danieldeesousa/FYDP/Hardware/FindMe_Hub/Hub_Schematic.pdf

# VBATTRED BLUE

A

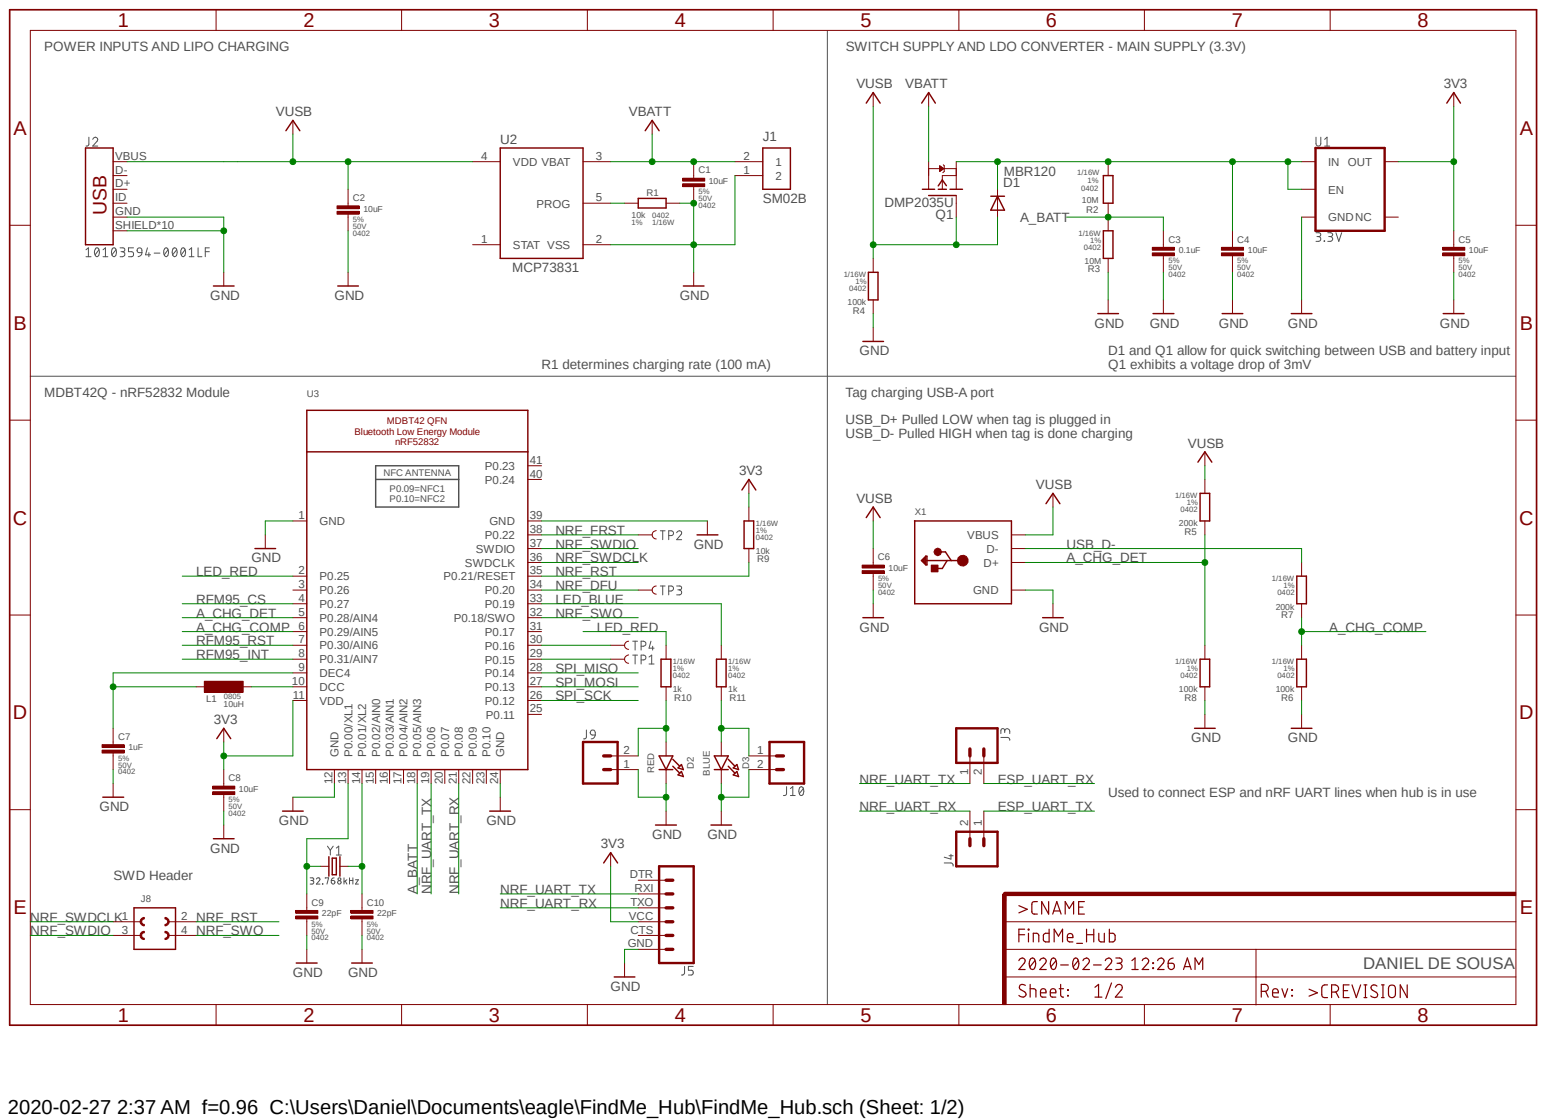
[picture p1: page 1]

POWER INPUTS AND LIPO CHARGING VUSB | SWITCH SUPPLY AND LDO CONVERTER - MAIN SUPPLY (3.3V) VUSB VBATT | 3V3

GND
D1 and Q1 allow for quick switching between USB and battery input

R1 determines charging rate (100 mA)

Q1 exhibits a voltage drop of 3mV

MDBT42Q - nRF52832 Module | | Tag charging USB-A port USB_D+ Pulled LOW when tag is plugged in USB_D- Pulled HIGH when tag is done charging VUSB

Bluetooth Low Energy Module

Used to connect ESP and nRF UART lines when hub is in use

2020-02-27 2:37 AM f=0.96 C:\Users\Daniel\Documents\eagle\FindMe_Hub\FindMe_Hub.sch (Sheet: 1/2)

# 3V3_ESP GND

A

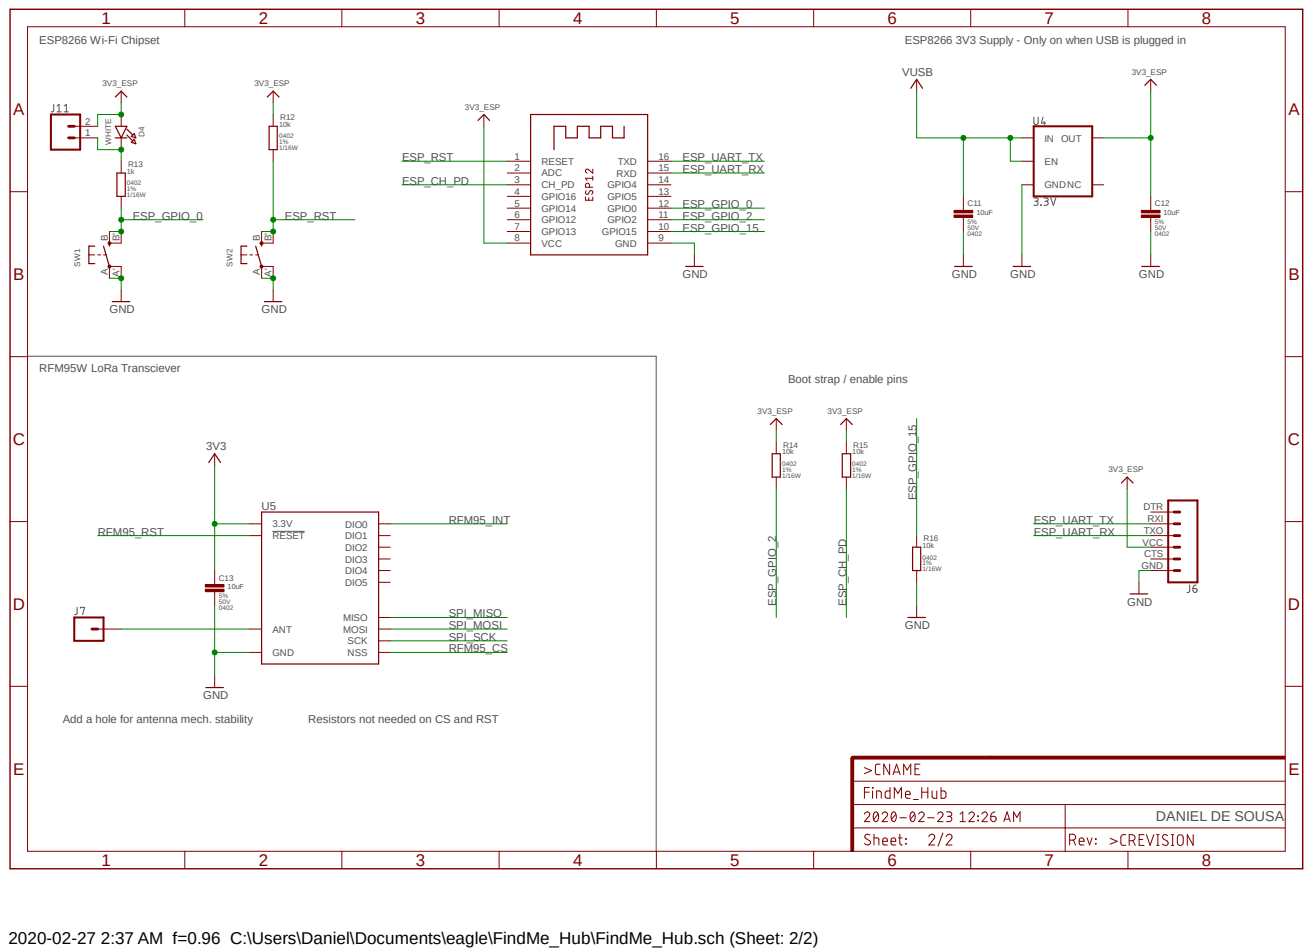
[picture p2: page 2]

ESP8266 3V3 Supply - Only on when USB is plugged in WHITE

Boot strap / enable pins

2020-02-27 2:37 AM f=0.96 C:\Users\Daniel\Documents\eagle\FindMe_Hub\FindMe_Hub.sch (Sheet: 2/2)
