danieldeesousa/FYDP/Hardware/FindMe_Tag/Tag_Schematic.pdf

A

A

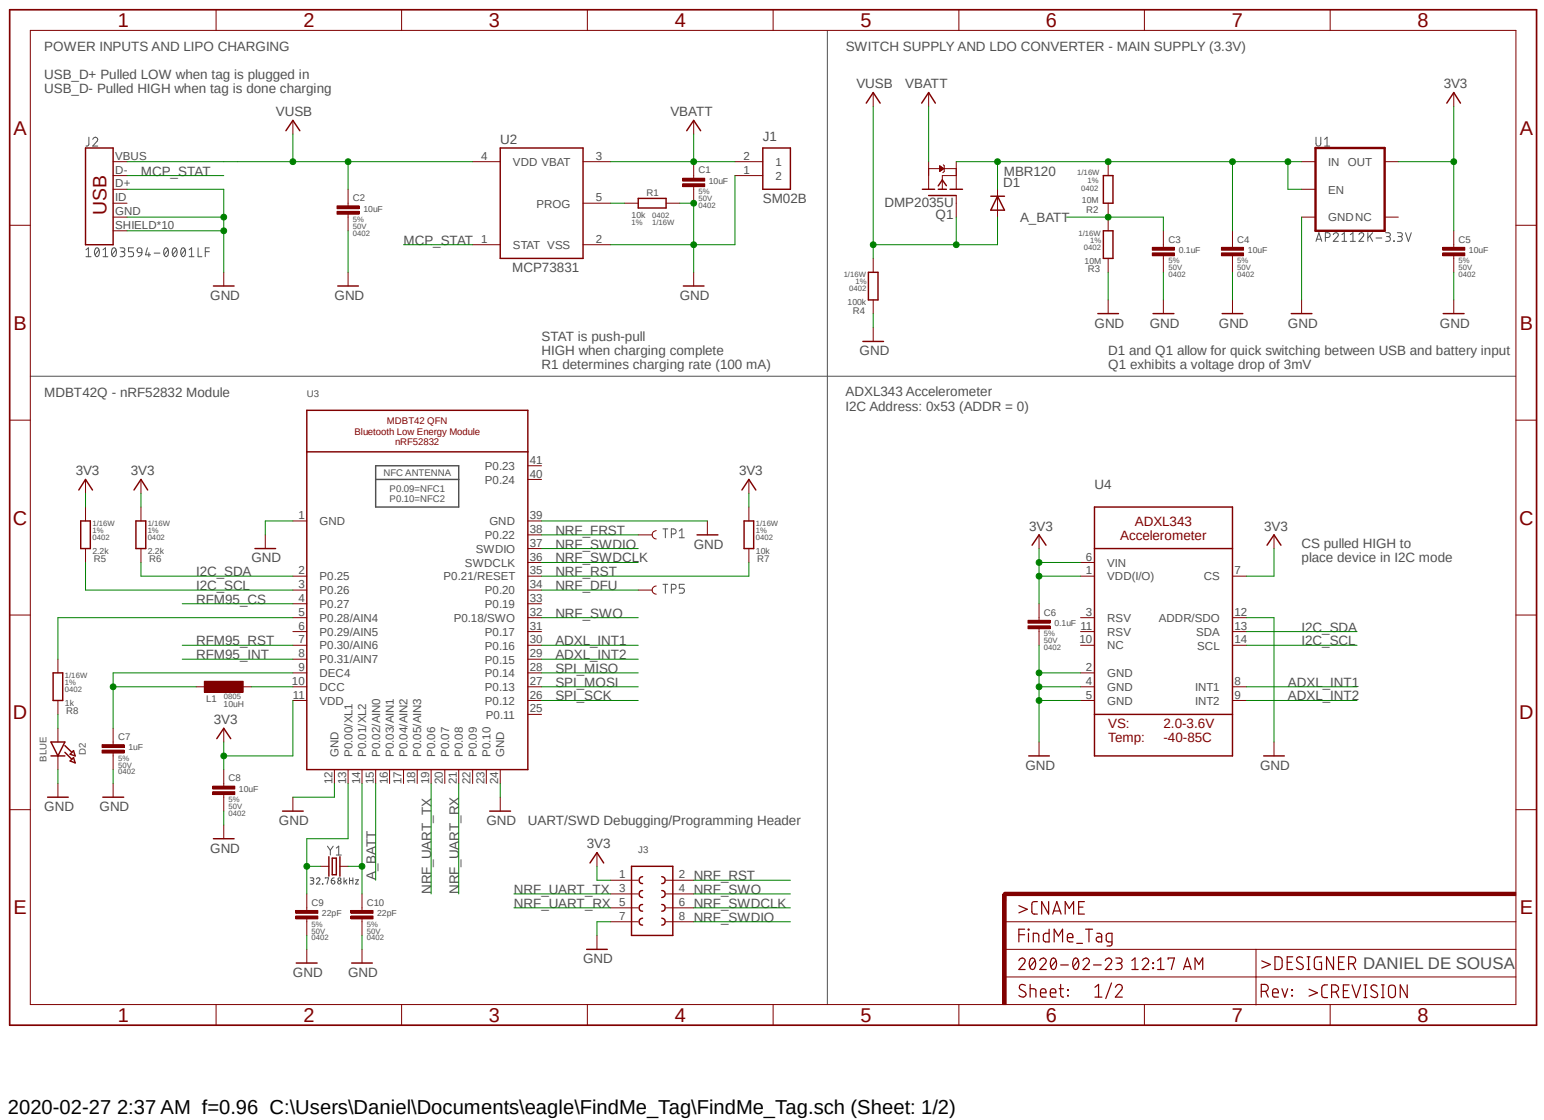
[picture p3: page 1]

USB_D+ Pulled LOW when tag is plugged in
USB_D- Pulled HIGH when tag is done charging

GND
D1 and Q1 allow for quick switching between USB and battery input
Q1 exhibits a voltage drop of 3mV

STAT is push-pull
HIGH when charging complete
R1 determines charging rate (100 mA)

MDBT42 QFN
Bluetooth Low Energy Module

CS pulled HIGH to
place device in I2C mode

UART/SWD Debugging/Programming Header

2020-02-27 2:37 AM f=0.96 C:\Users\Daniel\Documents\eagle\FindMe_Tag\FindMe_Tag.sch (Sheet: 1/2)

A

A

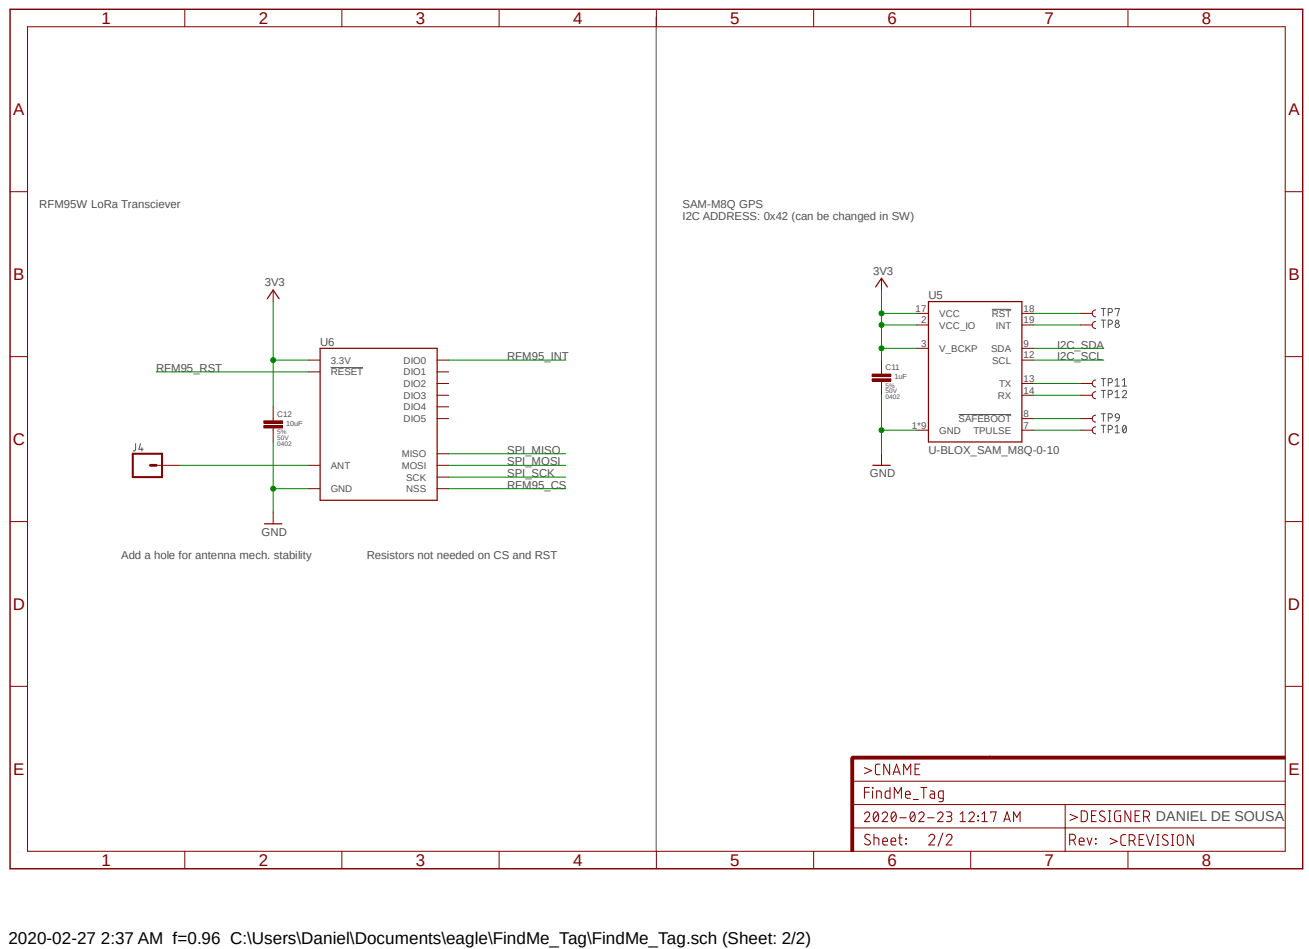
[picture p4: page 2]
RFM95W LoRa Transciever; Add a hole for antenna mech. stability; Resistors not needed on CS and RST; GND; U-BLOX_SAM_M8Q-0-10; 3V3 RESET; ANT; DIO0 DIO1 DIO2 DIO3 DIO4 DIO5 GND; MISO MOSI NSS; SCK U6; GND 1*9; VCC 17; RST; INT; 19 SDA; 9 SCL; 14 SAFEBOOT; 8 TPULSE; 7 V_BCKP 3; VCC_IO 2 U5 C12; C11 SPI_SCK; SPI_MOSI; SPI_MISO; RFM95_CS; RFM95_RST; RFM95_INT; I2C_SDA I2C_SCL

SAM-M8Q GPS
I2C ADDRESS: 0x42 (can be changed in SW)

DANIEL DE SOUSA

2020-02-27 2:37 AM f=0.96 C:\Users\Daniel\Documents\eagle\FindMe_Tag\FindMe_Tag.sch (Sheet: 2/2)
