danieldeesousa/FYDP/Hardware/FindMe_Tag/FindMe_Tag.brd

## EAGLE design Hardware/FindMe_Tag/FindMe_Tag.brd (2020-02-28)

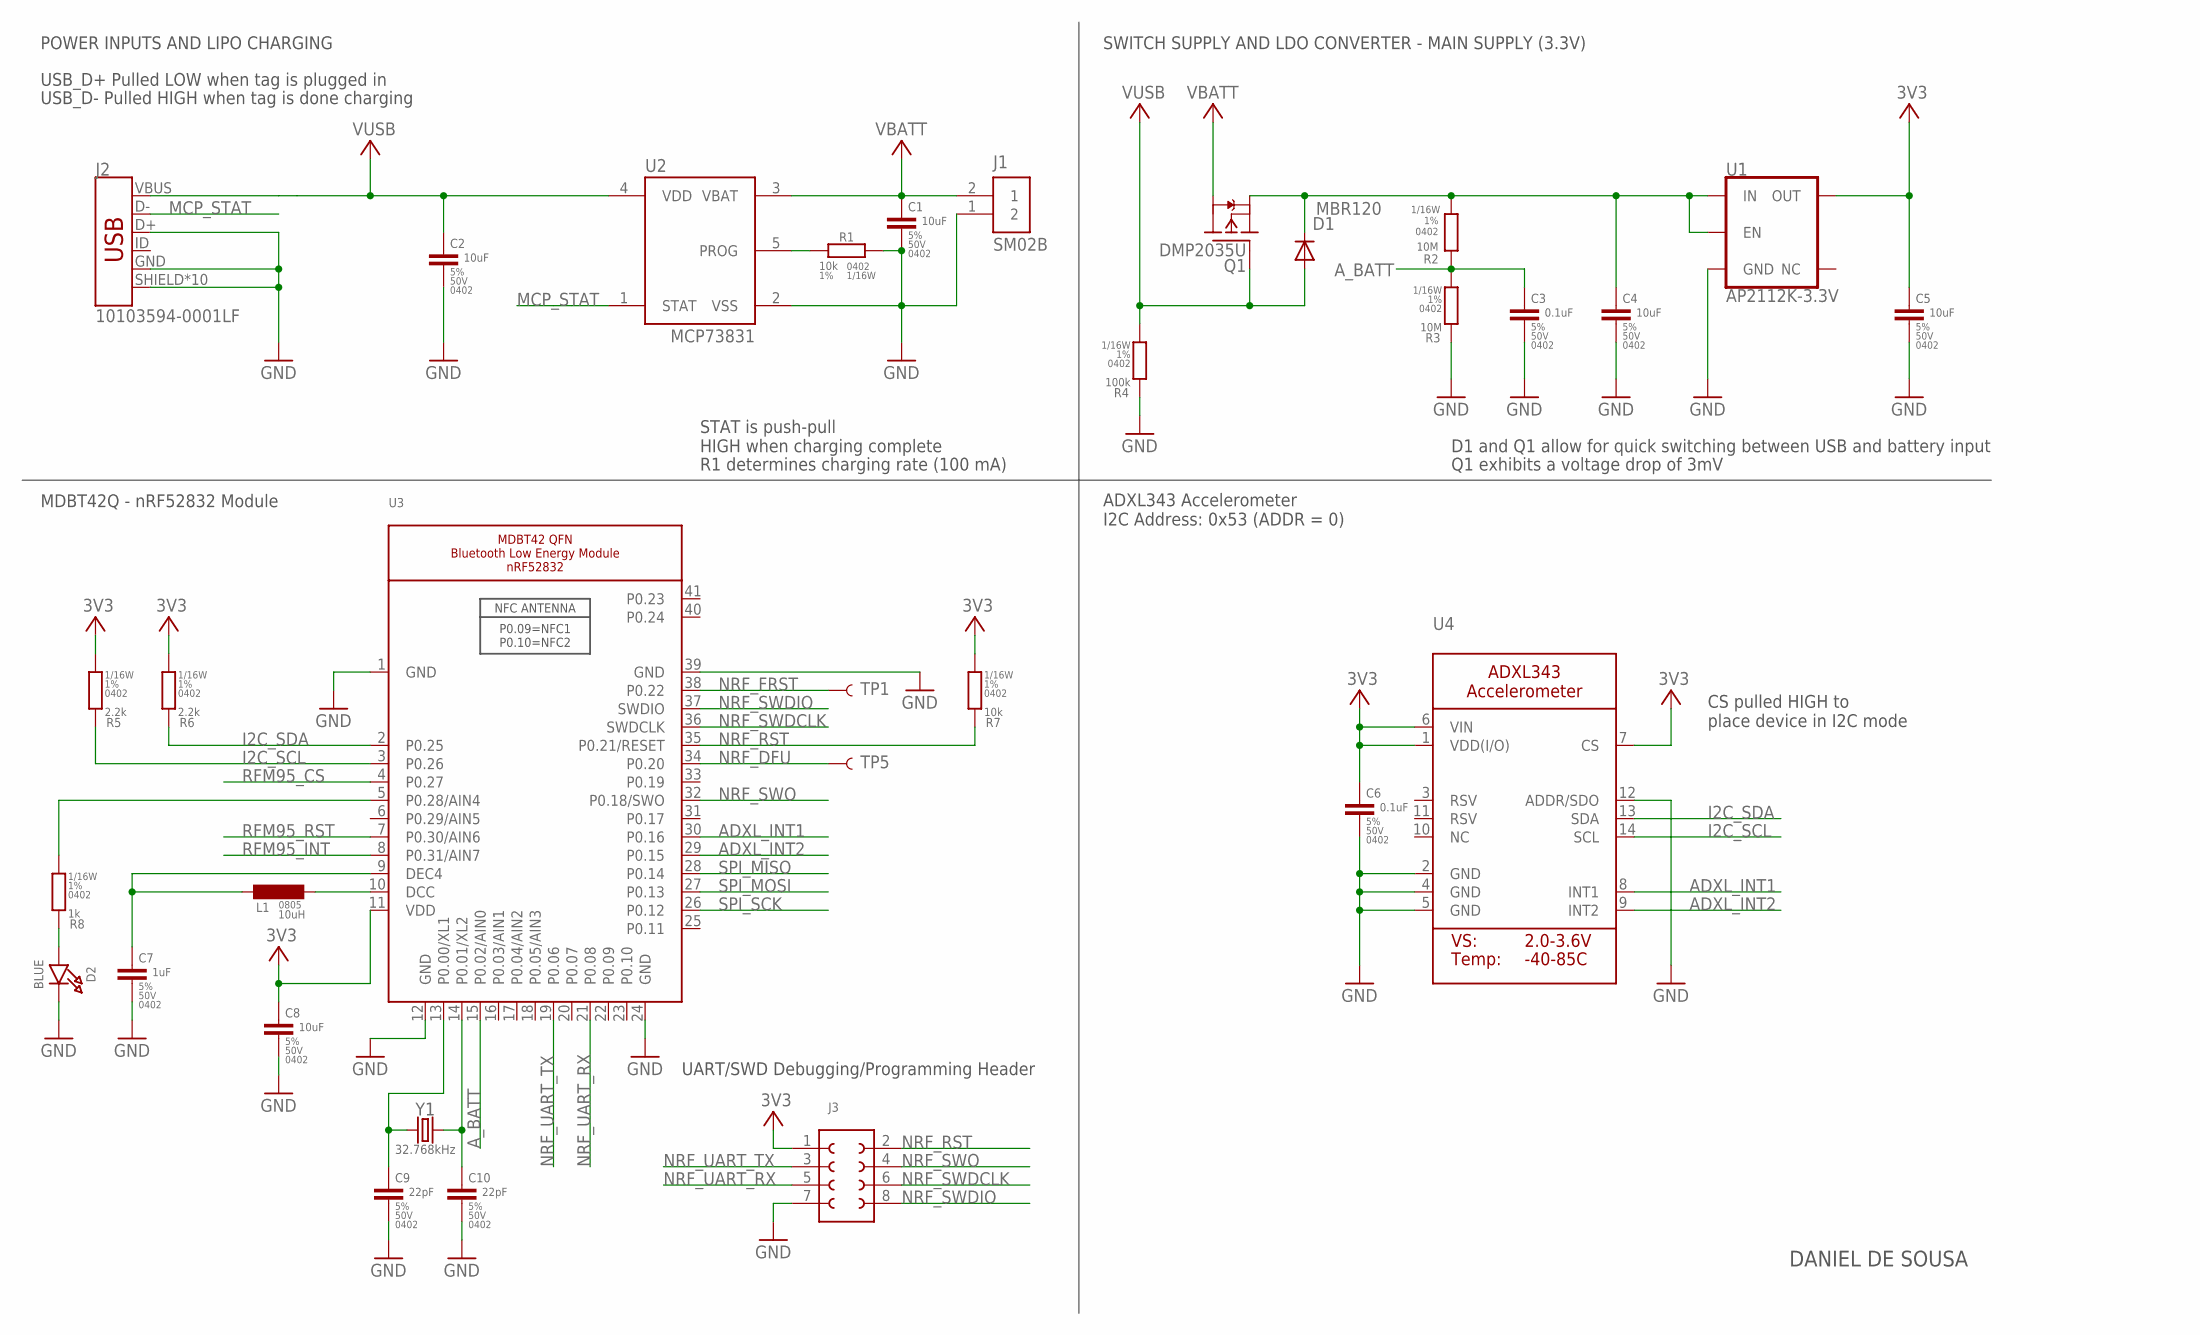
[picture p5: schematic FindMe_Tag.sch, sheet 1]

Parts:
C1, C2, C4, C5, C8: 10uF; C0402_MURATA_GRM15-GJM15
C3, C6: 0.1uF; C0402_MURATA_GRM15-GJM15
C7: 1uF; C0402_MURATA_GRM15-GJM15
C9, C10: 22pF; C0402_MURATA_GRM15-GJM15
D1: MBR120; SOD-123FL
D2: BLUE; CHIPLED_0805_NOOUTLINE
J1: SM02B; JST_SH_2X1
J2: 10103594-0001LF; USB-MICROB-PTH-MILL
J3: 610X08243021
L1: 10uH; L0805_MURATA_LQM21
Q1: DMP2035U; SOT23
R1, R7: 10k; R0402_VISHAY_CRCW0402
R2, R3: 10M; R0402_VISHAY_CRCW0402
R4: 100k; R0402_VISHAY_CRCW0402
R5, R6: 2.2k; R0402_VISHAY_CRCW0402
R8: 1k; R0402_VISHAY_CRCW0402
TP1, TP5: TEST-POINT3; PAD.03X.03
U1: AP2112K-3.3V; SOT23-5
U2: MCP73831; SOT-23
U3: NRF52832_MODULE_MDBT42; BLE_MODULE_RAYTAC_MDBT42
U4: ACCEL_ADXL343; LGA14
Y1: 32.768kHz; CRYSTAL-SMD-3.2X1.5MM

Connections:
+3V3: C5.1, C6.1, C8.1, J3.1, R5.2, R6.2, R7.2, U1.5 (OUT), U3.11 (VDD), U4.1 (VDD(I/O)), U4.6 (VIN), U4.7 (CS); also elsewhere on the board
ADXL_INT1: U3.30 (P0.16), U4.8 (INT1)
ADXL_INT2: U3.29 (P0.15), U4.9 (INT2)
A_BATT: C3.1, R2.1, R3.2, U3.15 (P0.02/AIN0)
GND: C1.2, C2.2, C3.2, C4.2, C5.2, C6.2, C7.2, C8.2, C9.2, C10.2, D2.C, J1.1 (2), J2.D+, J2.GND, J2.SHIELD, J2.SHIELD2 (SHIELD), J2.SHIELD3 (SHIELD), J2.SHIELD4 (SHIELD), J2.SHIELD5 (SHIELD), J2.SHIELD6 (SHIELD), J2.SHIELD7 (SHIELD), J2.SHIELD8 (SHIELD), J2.SHIELD9 (SHIELD), J2.SHIELD10 (SHIELD), J3.7 (4), R1.1, R3.1, R4.1, U1.2 (GND), U2.2 (VSS), U3.1 (GND), U3.12 (GND), U3.24 (GND), U3.39 (GND), U4.2 (GND), U4.4 (GND), U4.5 (GND), U4.12 (ADDR/SDO); also elsewhere on the board
I2C_SCL: R5.1, U3.3 (P0.26), U4.14 (SCL); also elsewhere on the board
I2C_SDA: R6.1, U3.2 (P0.25), U4.13 (SDA); also elsewhere on the board
MCP_STAT: J2.D-, U2.1 (STAT)
unnamed: R1.2, U2.5 (PROG)
unnamed: C4.1, D1.C, Q1.E (S), R2.2, U1.1 (IN), U1.3 (EN)
unnamed: C9.1, U3.13 (P0.00/XL1), Y1.P$1 (1)
unnamed: C10.1, U3.14 (P0.01/XL2), Y1.P$2 (2)
unnamed: L1.P$2 (2), U3.10 (DCC)
unnamed: C7.1, L1.P$1 (1), U3.9 (DEC4)
unnamed: R8.2, U3.5 (P0.28/AIN4)
unnamed: D2.A, R8.1
NRF_DFU: TP5.P$1, U3.34 (P0.20)
NRF_FRST: TP1.P$1, U3.38 (P0.22)
NRF_RST: J3.2 (8), R7.1, U3.35 (P0.21/RESET)
NRF_SWDCLK: J3.6, U3.36 (SWDCLK)
NRF_SWDIO: J3.8 (5), U3.37 (SWDIO)
NRF_SWO: J3.4 (7), U3.32 (P0.18/SWO)
NRF_UART_RX: J3.5 (3), U3.21 (P0.08)
NRF_UART_TX: J3.3 (2), U3.19 (P0.06)
RFM95_CS: U3.4 (P0.27); also elsewhere on the board
RFM95_INT: U3.8 (P0.31/AIN7); also elsewhere on the board
RFM95_RST: U3.7 (P0.30/AIN6); also elsewhere on the board
SPI_MISO: U3.28 (P0.14); also elsewhere on the board
SPI_MOSI: U3.27 (P0.13); also elsewhere on the board
SPI_SCK: U3.26 (P0.12); also elsewhere on the board
VBATT: C1.1, J1.2 (1), Q1.C (D), U2.3 (VBAT)
VUSB: C2.1, D1.A, J2.VBUS, Q1.B (G), R4.2, U2.4 (VDD)

Notes on the sheet:
ADXL343 Accelerometer I2C Address: 0x53 (ADDR = 0)
POWER INPUTS AND LIPO CHARGING
SWITCH SUPPLY AND LDO CONVERTER - MAIN SUPPLY (3.3V)
STAT is push-pull HIGH when charging complete
R1 determines charging rate (100 mA)
D1 and Q1 allow for quick switching between USB and battery input
DANIEL DE SOUSA
Q1 exhibits a voltage drop of 3mV
MDBT42Q - nRF52832 Module
USB_D- Pulled HIGH when tag is done charging
USB_D+ Pulled LOW when tag is plugged in
CS pulled HIGH to place device in I2C mode
UART/SWD Debugging/Programming Header

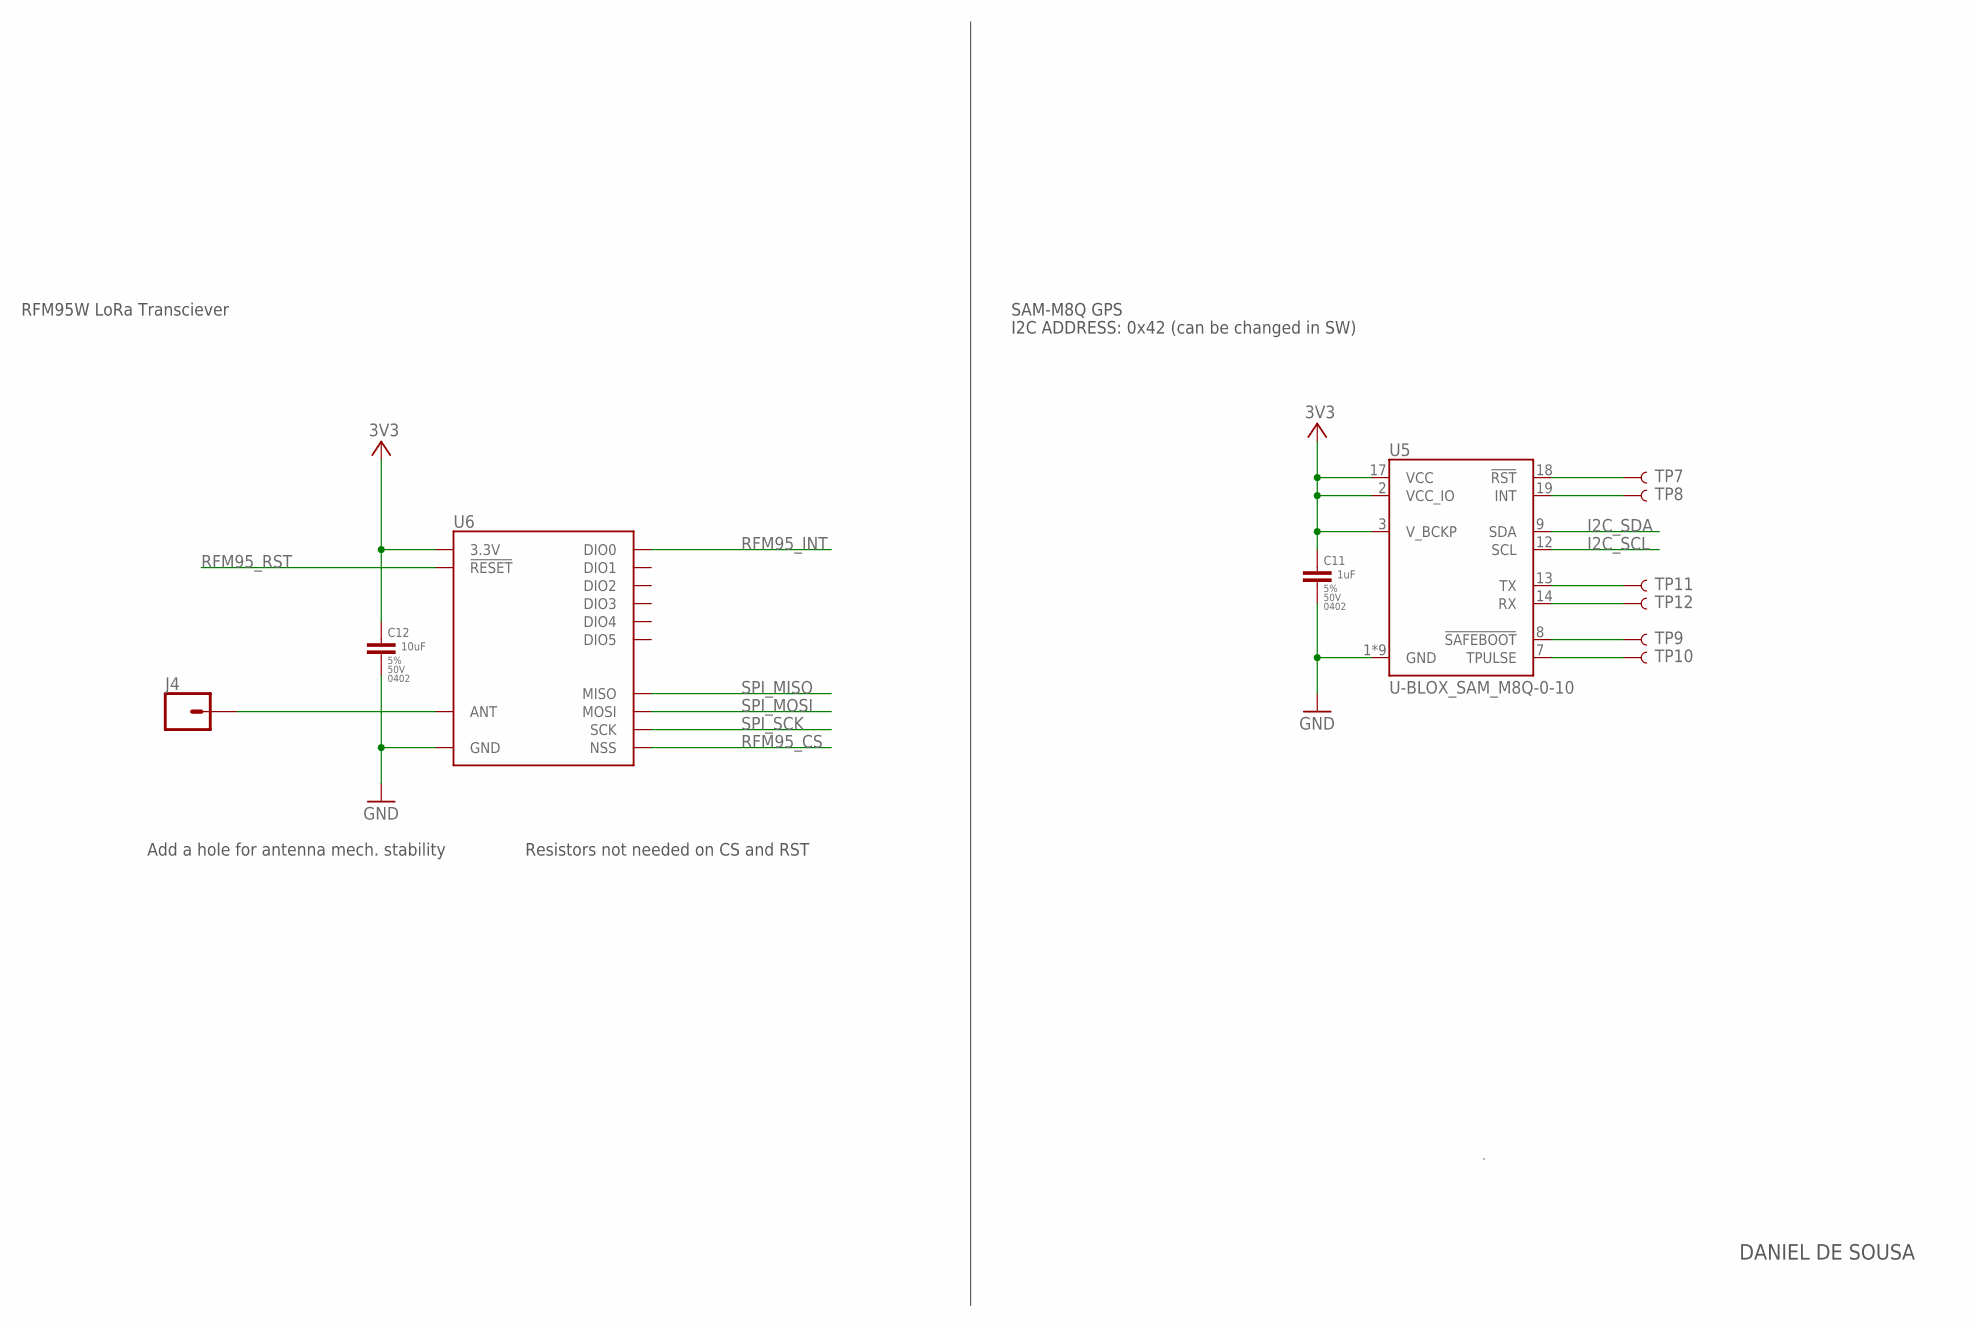
[picture p6: schematic FindMe_Tag.sch, sheet 2]

Parts:
C11: 1uF; C0402_MURATA_GRM15-GJM15
C12: 10uF; C0402_MURATA_GRM15-GJM15
J4: CONN_01PTH_NO_SILK_YES_STOP; 1X01_NO_SILK
TP7, TP8, TP9, TP10, TP11, TP12: TEST-POINT3; PAD.03X.03
U5: U-BLOX_SAM_M8Q-0-10; SAM-M8Q
U6: RFM95W; RFM95/96/97/98W

Connections:
+3V3: C11.1, C12.1, U5.2 (VCC_IO), U5.3 (V_BCKP), U5.17 (VCC), U6.3.3V; also elsewhere on the board
GND: C11.2, C12.2, U5.1 (GND), U5.4 (GND), U5.5 (GND), U5.6 (GND), U5.10 (GND), U5.11 (GND), U5.15 (GND), U5.16 (GND), U5.20 (GND), U6.GND@1 (GND), U6.GND@2 (GND), U6.GND@3 (GND); also elsewhere on the board
I2C_SCL: U5.12 (SCL); also elsewhere on the board
I2C_SDA: U5.9 (SDA); also elsewhere on the board
unnamed: J4.1, U6.ANT
unnamed: TP7.P$1, U5.18 (!RST)
unnamed: TP8.P$1, U5.19 (INT)
unnamed: TP9.P$1, U5.8 (!SAFEBOOT)
unnamed: TP10.P$1, U5.7 (TPULSE)
unnamed: TP11.P$1, U5.13 (TX)
unnamed: TP12.P$1, U5.14 (RX)
RFM95_CS: U6.NSS; also elsewhere on the board
RFM95_INT: U6.DIO0; also elsewhere on the board
RFM95_RST: U6.!RESET; also elsewhere on the board
SPI_MISO: U6.MISO; also elsewhere on the board
SPI_MOSI: U6.MOSI; also elsewhere on the board
SPI_SCK: U6.SCK; also elsewhere on the board

Notes on the sheet:
SAM-M8Q GPS
DANIEL DE SOUSA
I2C ADDRESS: 0x42 (can be changed in SW)
RFM95W LoRa Transciever
Resistors not needed on CS and RST
Add a hole for antenna mech. stability

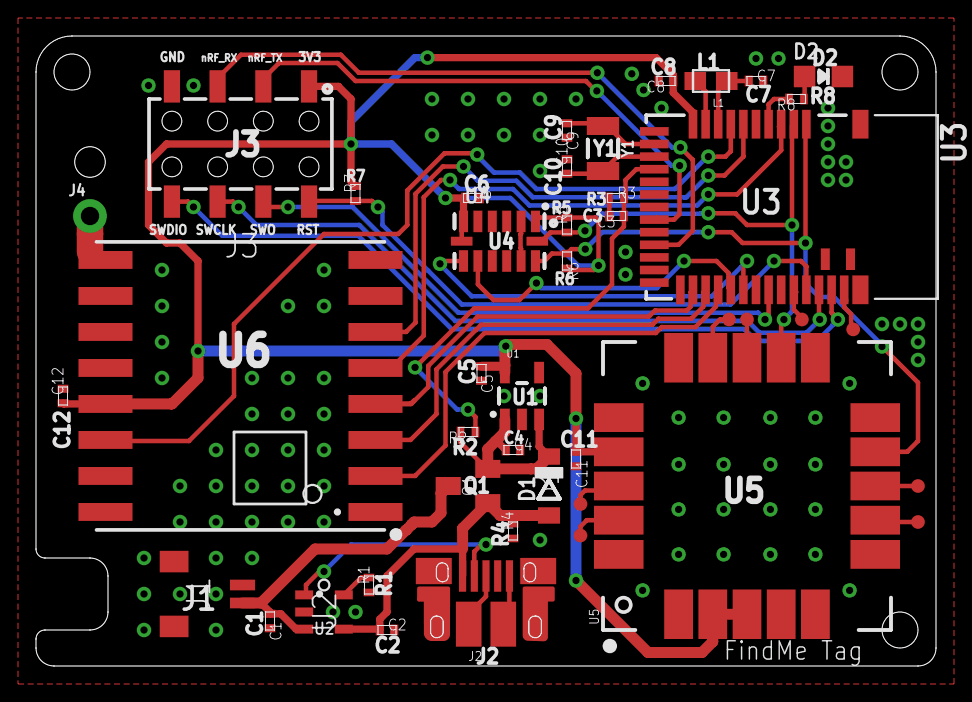
[picture p7: board FindMe_Tag.brd from above]

Board: 2 copper layers, 50.0 x 35.0 mm, 43 parts (0 on the bottom side), 39 nets.
