danieldeesousa/FYDP/Hardware/FindMe_Hub/FindMe_Hub.brd

## EAGLE design Hardware/FindMe_Hub/FindMe_Hub.brd (2020-02-28)

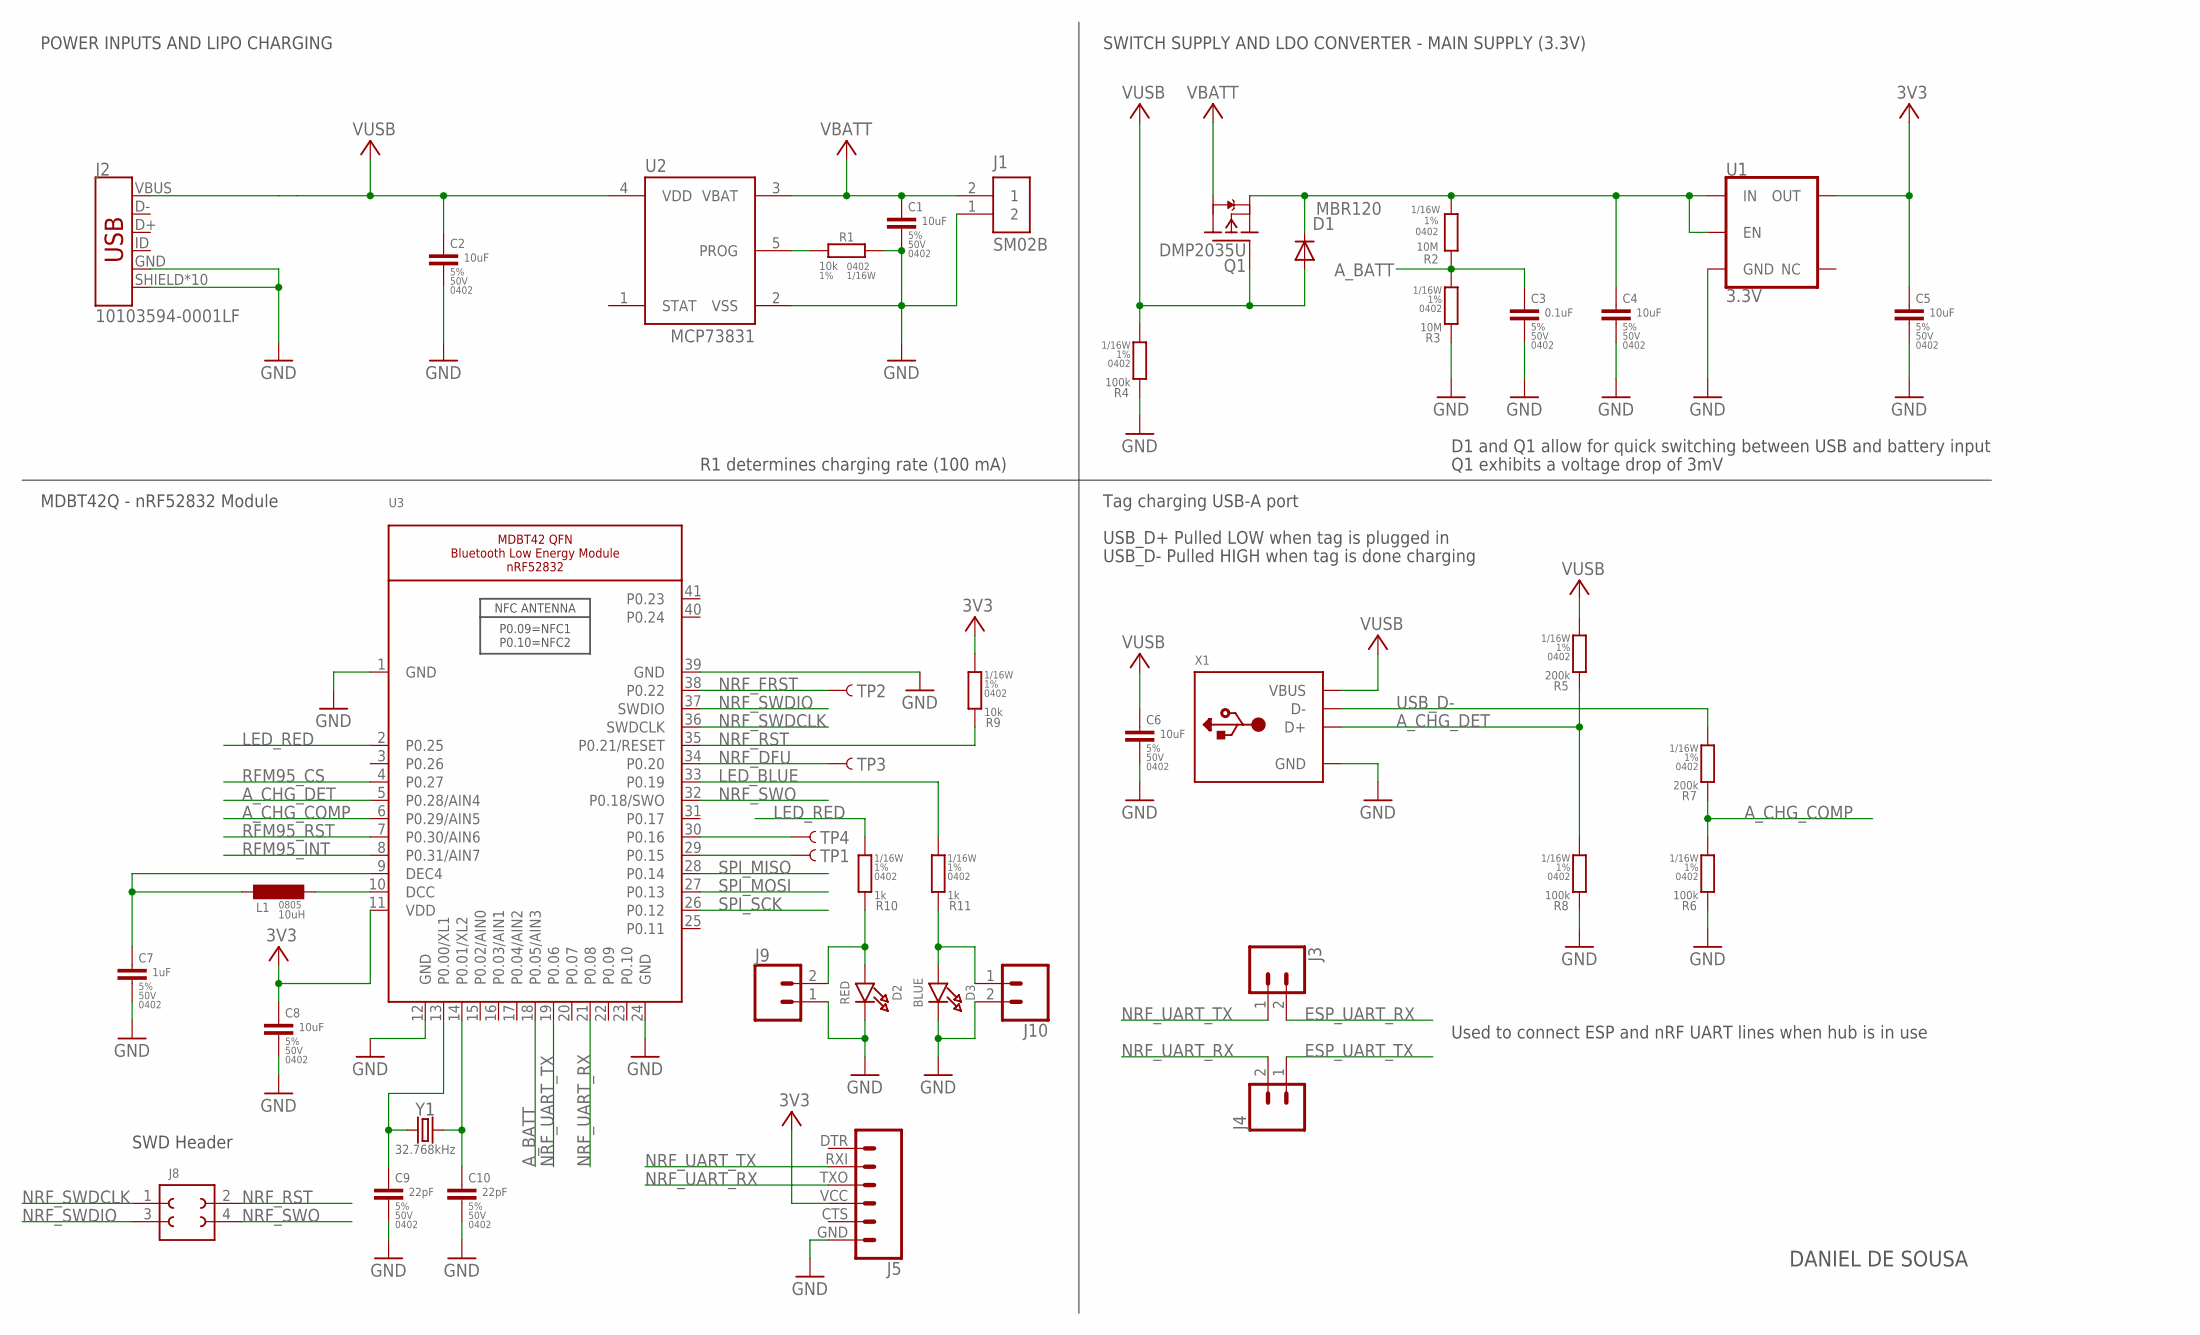
[picture p8: schematic FindMe_Hub.sch, sheet 1]

Parts:
C1, C2, C4, C5, C6, C8: 10uF; C0402_MURATA_GRM15-GJM15
C3: 0.1uF; C0402_MURATA_GRM15-GJM15
C7: 1uF; C0402_MURATA_GRM15-GJM15
C9, C10: 22pF; C0402_MURATA_GRM15-GJM15
D1: MBR120; SOD-123FL
D2: RED; CHIPLED_0805_NOOUTLINE
D3: BLUE; CHIPLED_0805_NOOUTLINE
J1: SM02B; JST_SH_2X1
J2: 10103594-0001LF; USB-MICROB-PTH-MILL
J3, J4, J9, J10: CONN_02; 1X02
J5: 6_PIN_SERIAL_CABLEPTH; FTDI_BASIC
J8: 610X0421121
L1: 10uH; L0805_MURATA_LQM21
Q1: DMP2035U; SOT23
R1, R9: 10k; R0402_VISHAY_CRCW0402
R2, R3: 10M; R0402_VISHAY_CRCW0402
R4, R6, R8: 100k; R0402_VISHAY_CRCW0402
R5, R7: 200k; R0402_VISHAY_CRCW0402
R10, R11: 1k; R0402_VISHAY_CRCW0402
TP1, TP2, TP3, TP4: TEST-POINT3X5; PAD.03X.05
U1: 3.3V; SOT23-5
U2: MCP73831; SOT-23
U3: NRF52832_MODULE_MDBT42; BLE_MODULE_RAYTAC_MDBT42
X1: USB_TYPEAPTHFML; USB_HOST-PTH
Y1: 32.768kHz; CRYSTAL-SMD-3.2X1.5MM

Connections:
+3V3: C5.1, C8.1, J5.VCC (4), R9.2, U1.5 (OUT), U3.11 (VDD); also elsewhere on the board
A_BATT: C3.1, R2.1, R3.2, U3.18 (P0.05/AIN3)
A_CHG_COMP: R6.2, R7.1, U3.6 (P0.29/AIN5)
A_CHG_DET: R5.1, R8.2, U3.5 (P0.28/AIN4), X1.D+
ESP_UART_RX: J3.2; also elsewhere on the board
ESP_UART_TX: J4.1; also elsewhere on the board
GND: C1.2, C2.2, C3.2, C4.2, C5.2, C6.2, C7.2, C8.2, C9.2, C10.2, D2.C, D3.C, J1.1 (2), J2.GND, J2.SHIELD, J2.SHIELD2 (SHIELD), J2.SHIELD3 (SHIELD), J2.SHIELD4 (SHIELD), J2.SHIELD5 (SHIELD), J2.SHIELD6 (SHIELD), J2.SHIELD7 (SHIELD), J2.SHIELD8 (SHIELD), J2.SHIELD9 (SHIELD), J2.SHIELD10 (SHIELD), J5.GND (6), J9.1, J10.2, R1.1, R3.1, R4.1, R6.1, R8.1, U1.2 (GND), U2.2 (VSS), U3.1 (GND), U3.12 (GND), U3.24 (GND), U3.39 (GND), X1.GND; also elsewhere on the board
LED_BLUE: R11.2, U3.33 (P0.19)
LED_RED: R10.2, U3.2 (P0.25)
unnamed: C9.1, U3.13 (P0.00/XL1), Y1.P$1 (1)
unnamed: R1.2, U2.5 (PROG)
unnamed: C4.1, D1.C, Q1.E (S), R2.2, U1.1 (IN), U1.3 (EN)
unnamed: C10.1, U3.14 (P0.01/XL2), Y1.P$2 (2)
unnamed: TP4.P$1, U3.30 (P0.16)
unnamed: TP1.P$1, U3.29 (P0.15)
unnamed: D2.A, J9.2, R10.1
unnamed: L1.P$2 (2), U3.10 (DCC)
unnamed: C7.1, L1.P$1 (1), U3.9 (DEC4)
unnamed: D3.A, J10.1, R11.1
NRF_DFU: TP3.P$1, U3.34 (P0.20)
NRF_FRST: TP2.P$1, U3.38 (P0.22)
NRF_RST: J8.2 (4), R9.1, U3.35 (P0.21/RESET)
NRF_SWDCLK: J8.1, U3.36 (SWDCLK)
NRF_SWDIO: J8.3 (2), U3.37 (SWDIO)
NRF_SWO: J8.4 (3), U3.32 (P0.18/SWO)
NRF_UART_RX: J4.2, J5.TXO (3), U3.21 (P0.08)
NRF_UART_TX: J3.1, J5.RXI (2), U3.19 (P0.06)
RFM95_CS: U3.4 (P0.27); also elsewhere on the board
RFM95_INT: U3.8 (P0.31/AIN7); also elsewhere on the board
RFM95_RST: U3.7 (P0.30/AIN6); also elsewhere on the board
SPI_MISO: U3.28 (P0.14); also elsewhere on the board
SPI_MOSI: U3.27 (P0.13); also elsewhere on the board
SPI_SCK: U3.26 (P0.12); also elsewhere on the board
USB_D-: R7.2, X1.D-
VBATT: C1.1, J1.2 (1), Q1.C (D), U2.3 (VBAT)
VUSB: C2.1, C6.1, D1.A, J2.VBUS, Q1.B (G), R4.2, R5.2, U2.4 (VDD), X1.VBUS; also elsewhere on the board

Notes on the sheet:
POWER INPUTS AND LIPO CHARGING
SWITCH SUPPLY AND LDO CONVERTER - MAIN SUPPLY (3.3V)
R1 determines charging rate (100 mA)
D1 and Q1 allow for quick switching between USB and battery input
DANIEL DE SOUSA
Q1 exhibits a voltage drop of 3mV
MDBT42Q - nRF52832 Module
USB_D- Pulled HIGH when tag is done charging
USB_D+ Pulled LOW when tag is plugged in
Used to connect ESP and nRF UART lines when hub is in use
Tag charging USB-A port
SWD Header

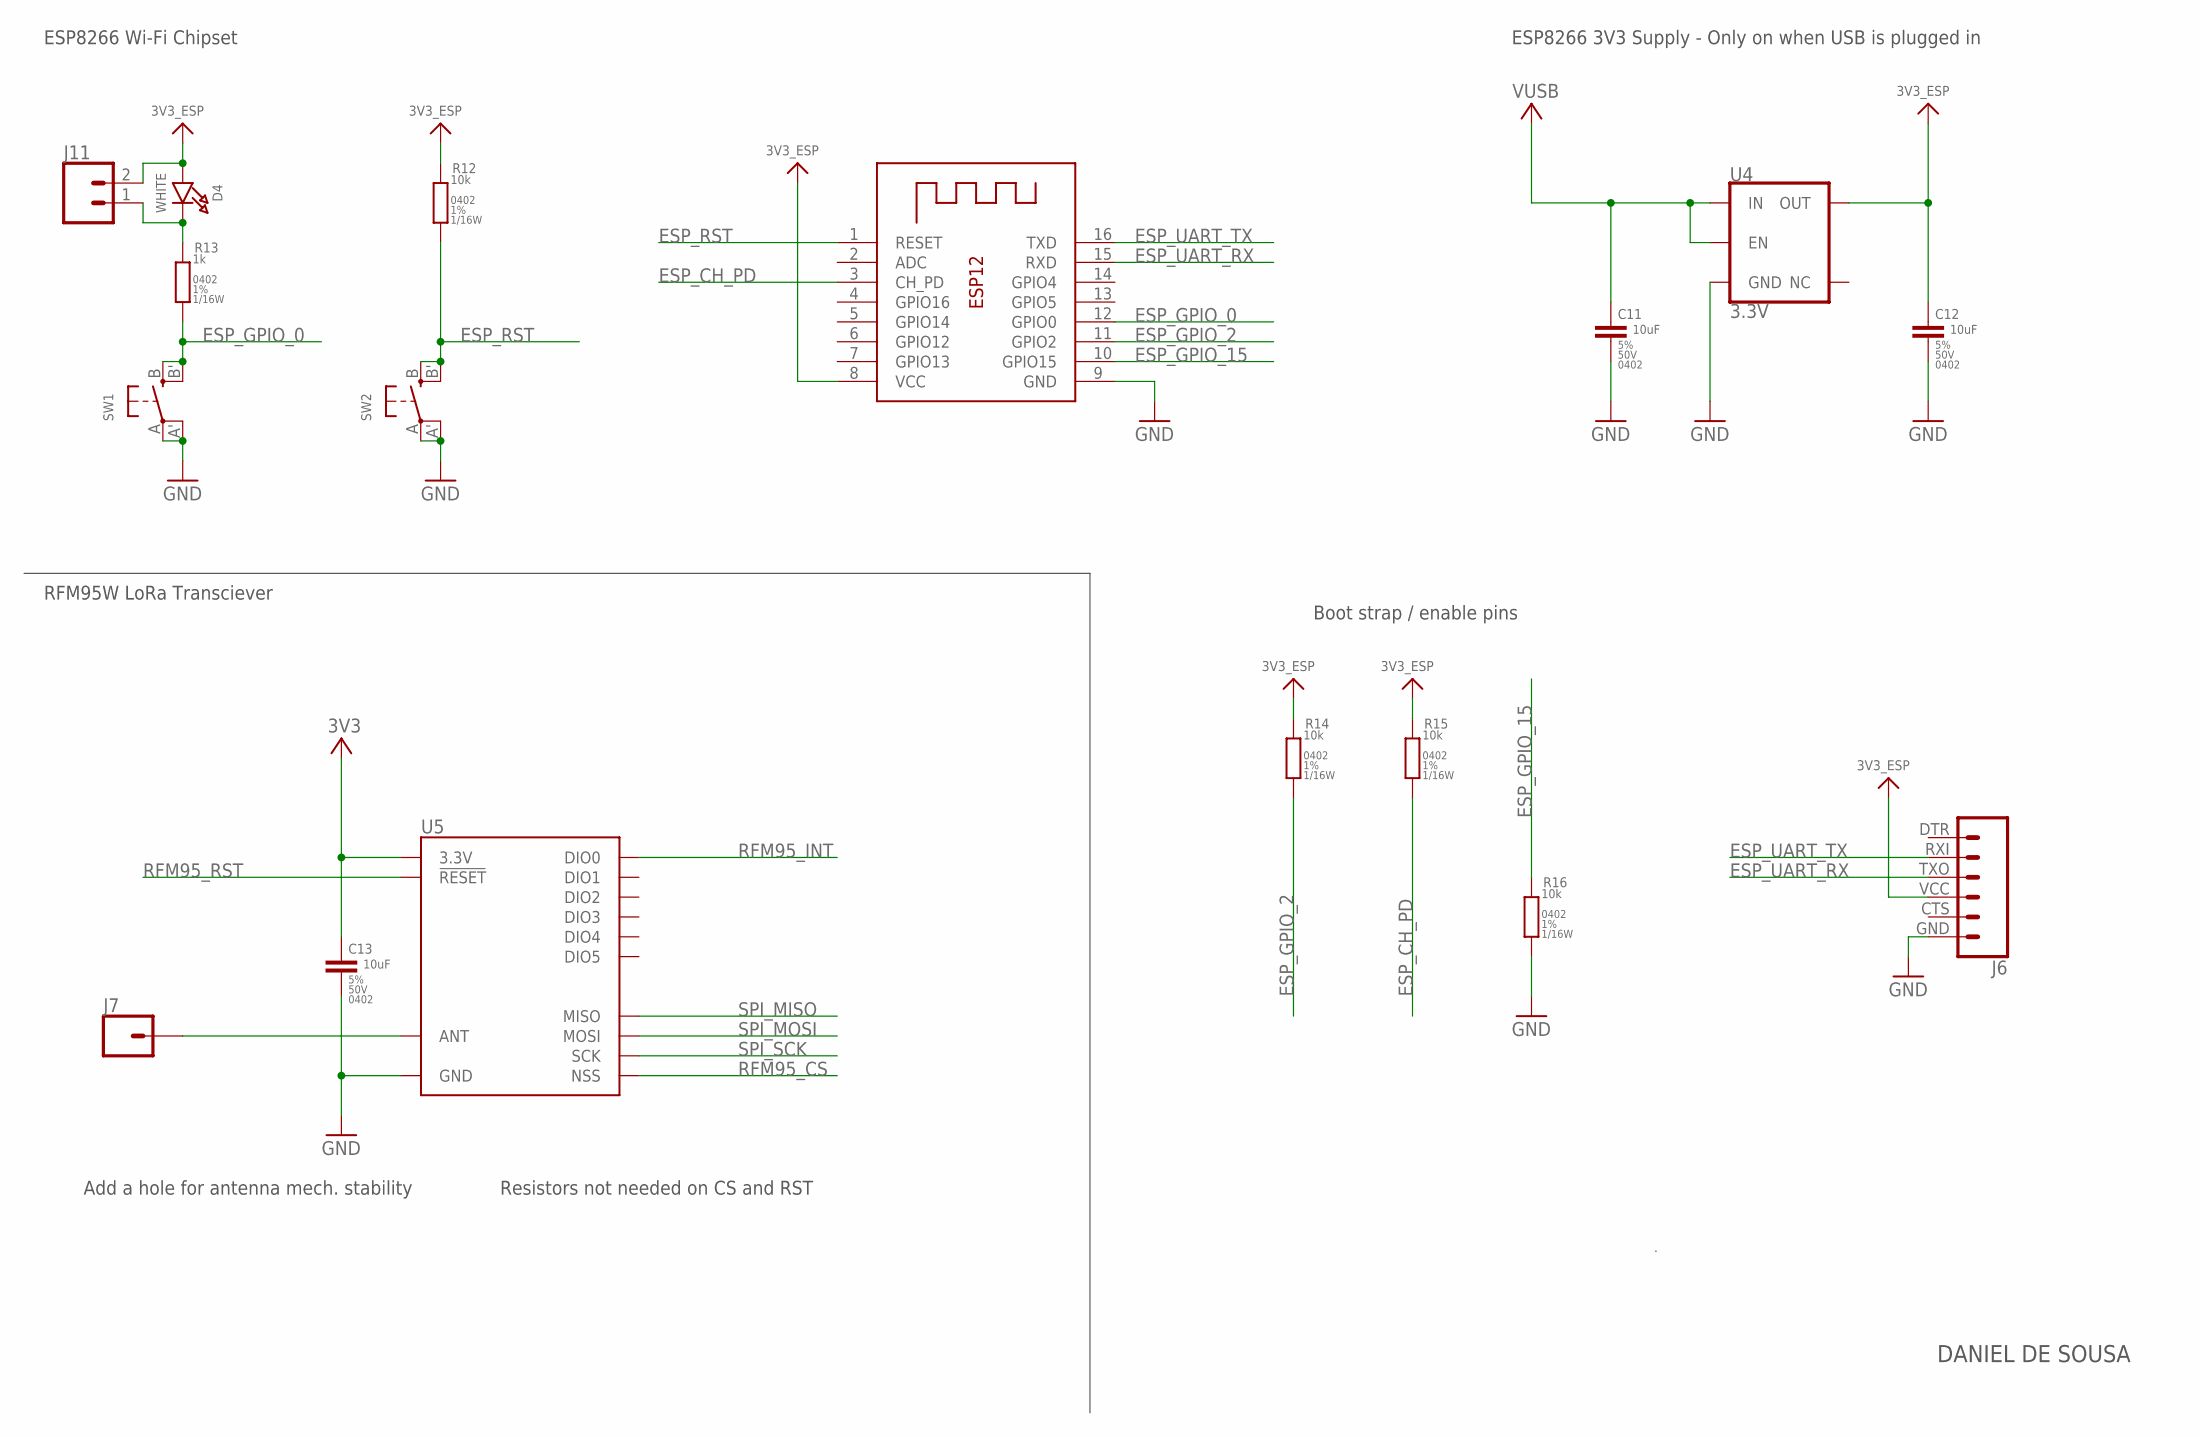
[picture p9: schematic FindMe_Hub.sch, sheet 2]

Parts:
C11, C12, C13: 10uF; C0402_MURATA_GRM15-GJM15
D4: WHITE; CHIPLED_0805_NOOUTLINE
J6: 6_PIN_SERIAL_CABLEPTH; FTDI_BASIC
J7: CONN_01PTH_NO_SILK_YES_STOP; 1X01_NO_SILK
J11: CONN_02; 1X02
R12, R14, R15, R16: 10k; R0402_VISHAY_CRCW0402
R13: 1k; R0402_VISHAY_CRCW0402
SW1, SW2: SWITCH_TACT_SMT4.6X2.8; BTN_KMR2_4.6X2.8
U4: 3.3V; SOT23-5
U5: RFM95W; RFM95/96/97/98W
X2: ESP-12

Connections:
+3V3: C13.1, U5.3.3V; also elsewhere on the board
ESP_CH_PD: R15.2, X2.3 (CH_PD)
ESP_GPIO_0: R13.2, SW1.B (S), SW1.B' (S1), X2.12 (GPIO0)
ESP_GPIO_2: R14.2, X2.11 (GPIO2)
ESP_GPIO_15: R16.1, X2.10 (GPIO15)
ESP_RST: R12.2, SW2.B (S), SW2.B' (S1), X2.1 (RESET)
ESP_UART_RX: J6.TXO (3), X2.15 (RXD); also elsewhere on the board
ESP_UART_TX: J6.RXI (2), X2.16 (TXD); also elsewhere on the board
GND: C11.2, C12.2, C13.2, J6.GND (6), R16.2, SW1.A, SW1.A' (P1), SW2.A, SW2.A' (P1), U4.2 (GND), U5.GND@1 (GND), U5.GND@2 (GND), U5.GND@3 (GND), X2.9 (GND); also elsewhere on the board
unnamed: J7.1, U5.ANT
unnamed: D4.C, J11.1, R13.1
RFM95_CS: U5.NSS; also elsewhere on the board
RFM95_INT: U5.DIO0; also elsewhere on the board
RFM95_RST: U5.!RESET; also elsewhere on the board
SPI_MISO: U5.MISO; also elsewhere on the board
SPI_MOSI: U5.MOSI; also elsewhere on the board
SPI_SCK: U5.SCK; also elsewhere on the board
VCCIO: C12.1, D4.A, J6.VCC (4), J11.2, R12.1, R14.1, R15.1, U4.5 (OUT), X2.8 (VCC)
VUSB: C11.1, U4.1 (IN), U4.3 (EN); also elsewhere on the board

Notes on the sheet:
RFM95W LoRa Transciever
ESP8266 Wi-Fi Chipset
DANIEL DE SOUSA
Resistors not needed on CS and RST
Add a hole for antenna mech. stability
Boot strap / enable pins
ESP8266 3V3 Supply - Only on when USB is plugged in

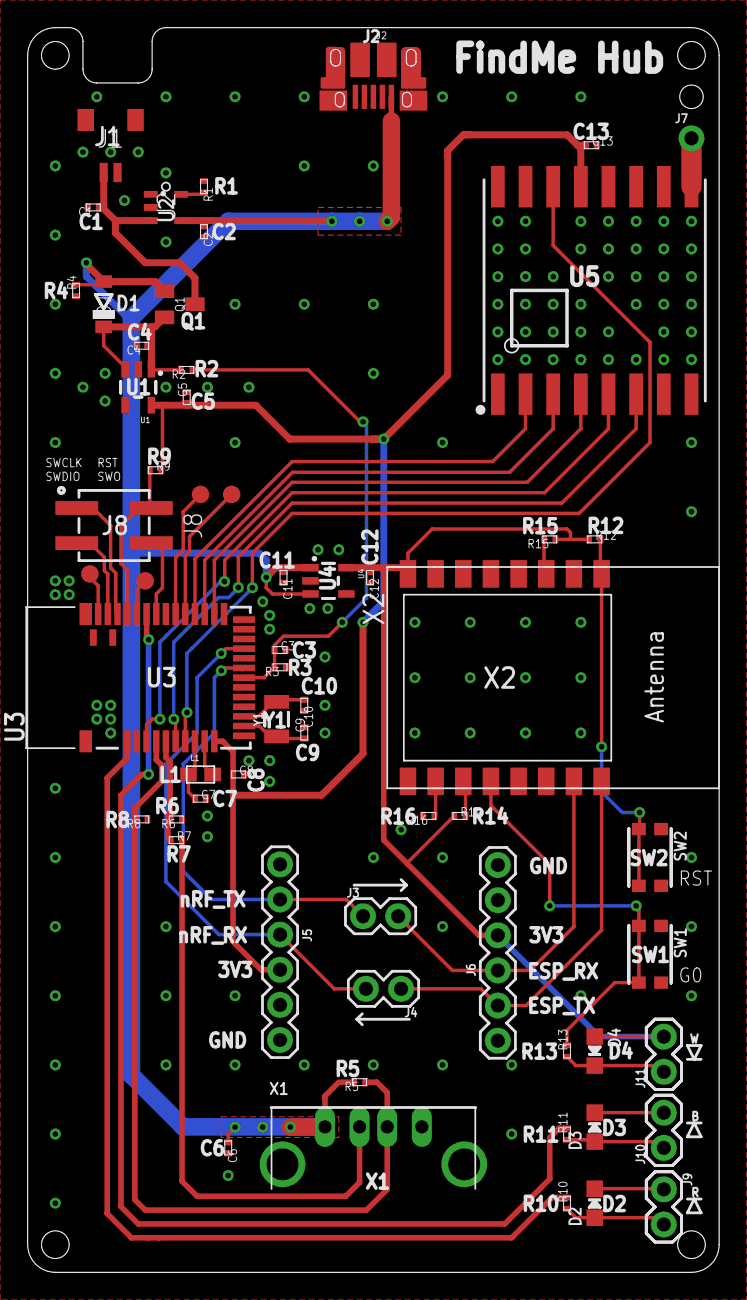
[picture p10: board FindMe_Hub.brd from above]

Board: 2 copper layers, 50.0 x 90.0 mm, 60 parts (0 on the bottom side), 44 nets.
